brianrho/Rho85/README.md

# Rho85
An Intel 8085 microprocessor trainer
