brianrho/Rho85/CAD/readme.txt

This contains the Eagle .brd and .sch files, as well as PNG images of the schematic and PCB design. 
The schematic has been modified to correct the issues discovered during testing but the PCB design 
is still flawed; yet to be re-routed.
