brianrho/Rho85/CAD/pcb.png

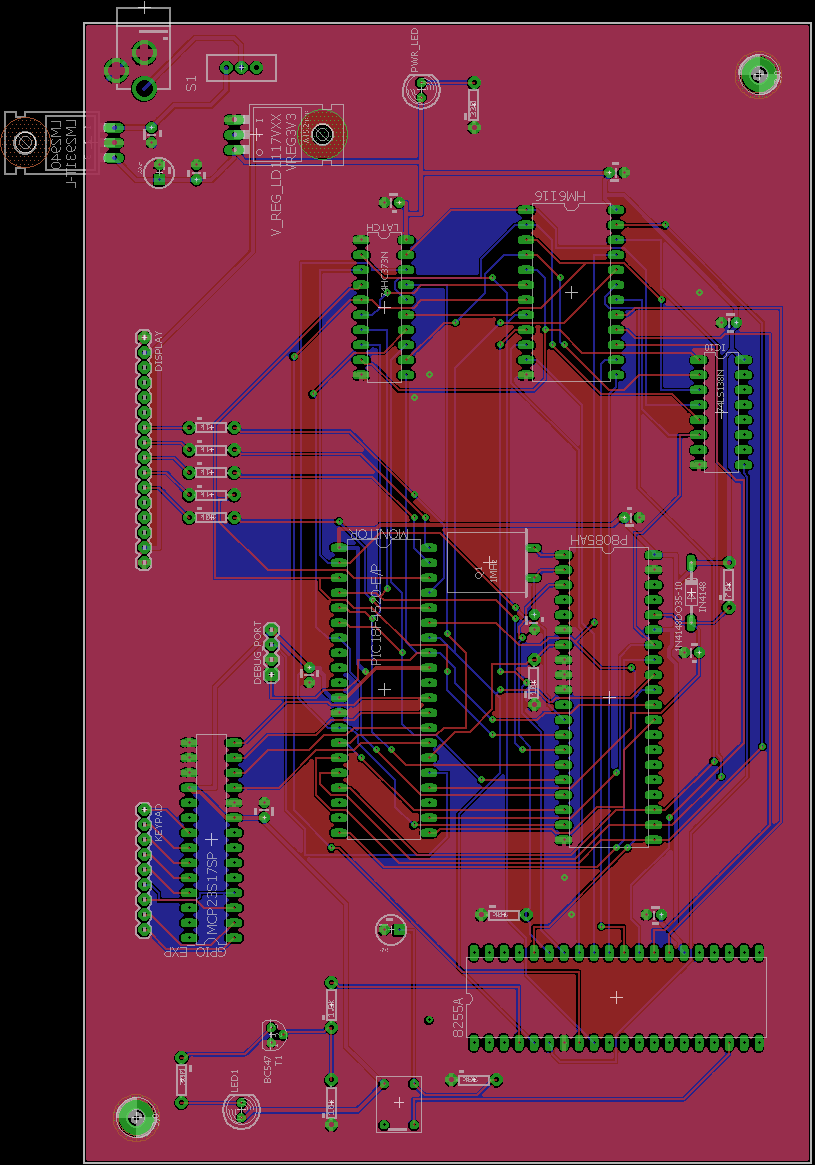
CAD/pcb.png
