brianrho/Rho85/CAD/schem.png

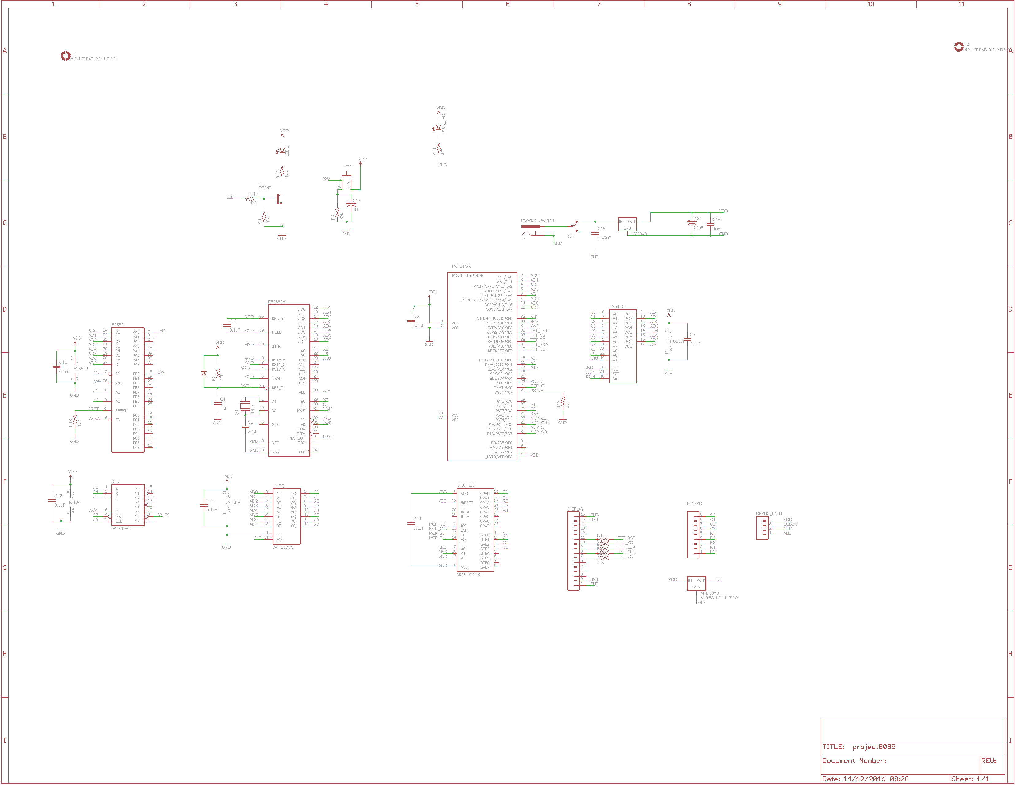
CAD/schem.png
