brianrho/Rho85/CAD/project8085.brd

## EAGLE design CAD/project8085.brd (2016-12-26)

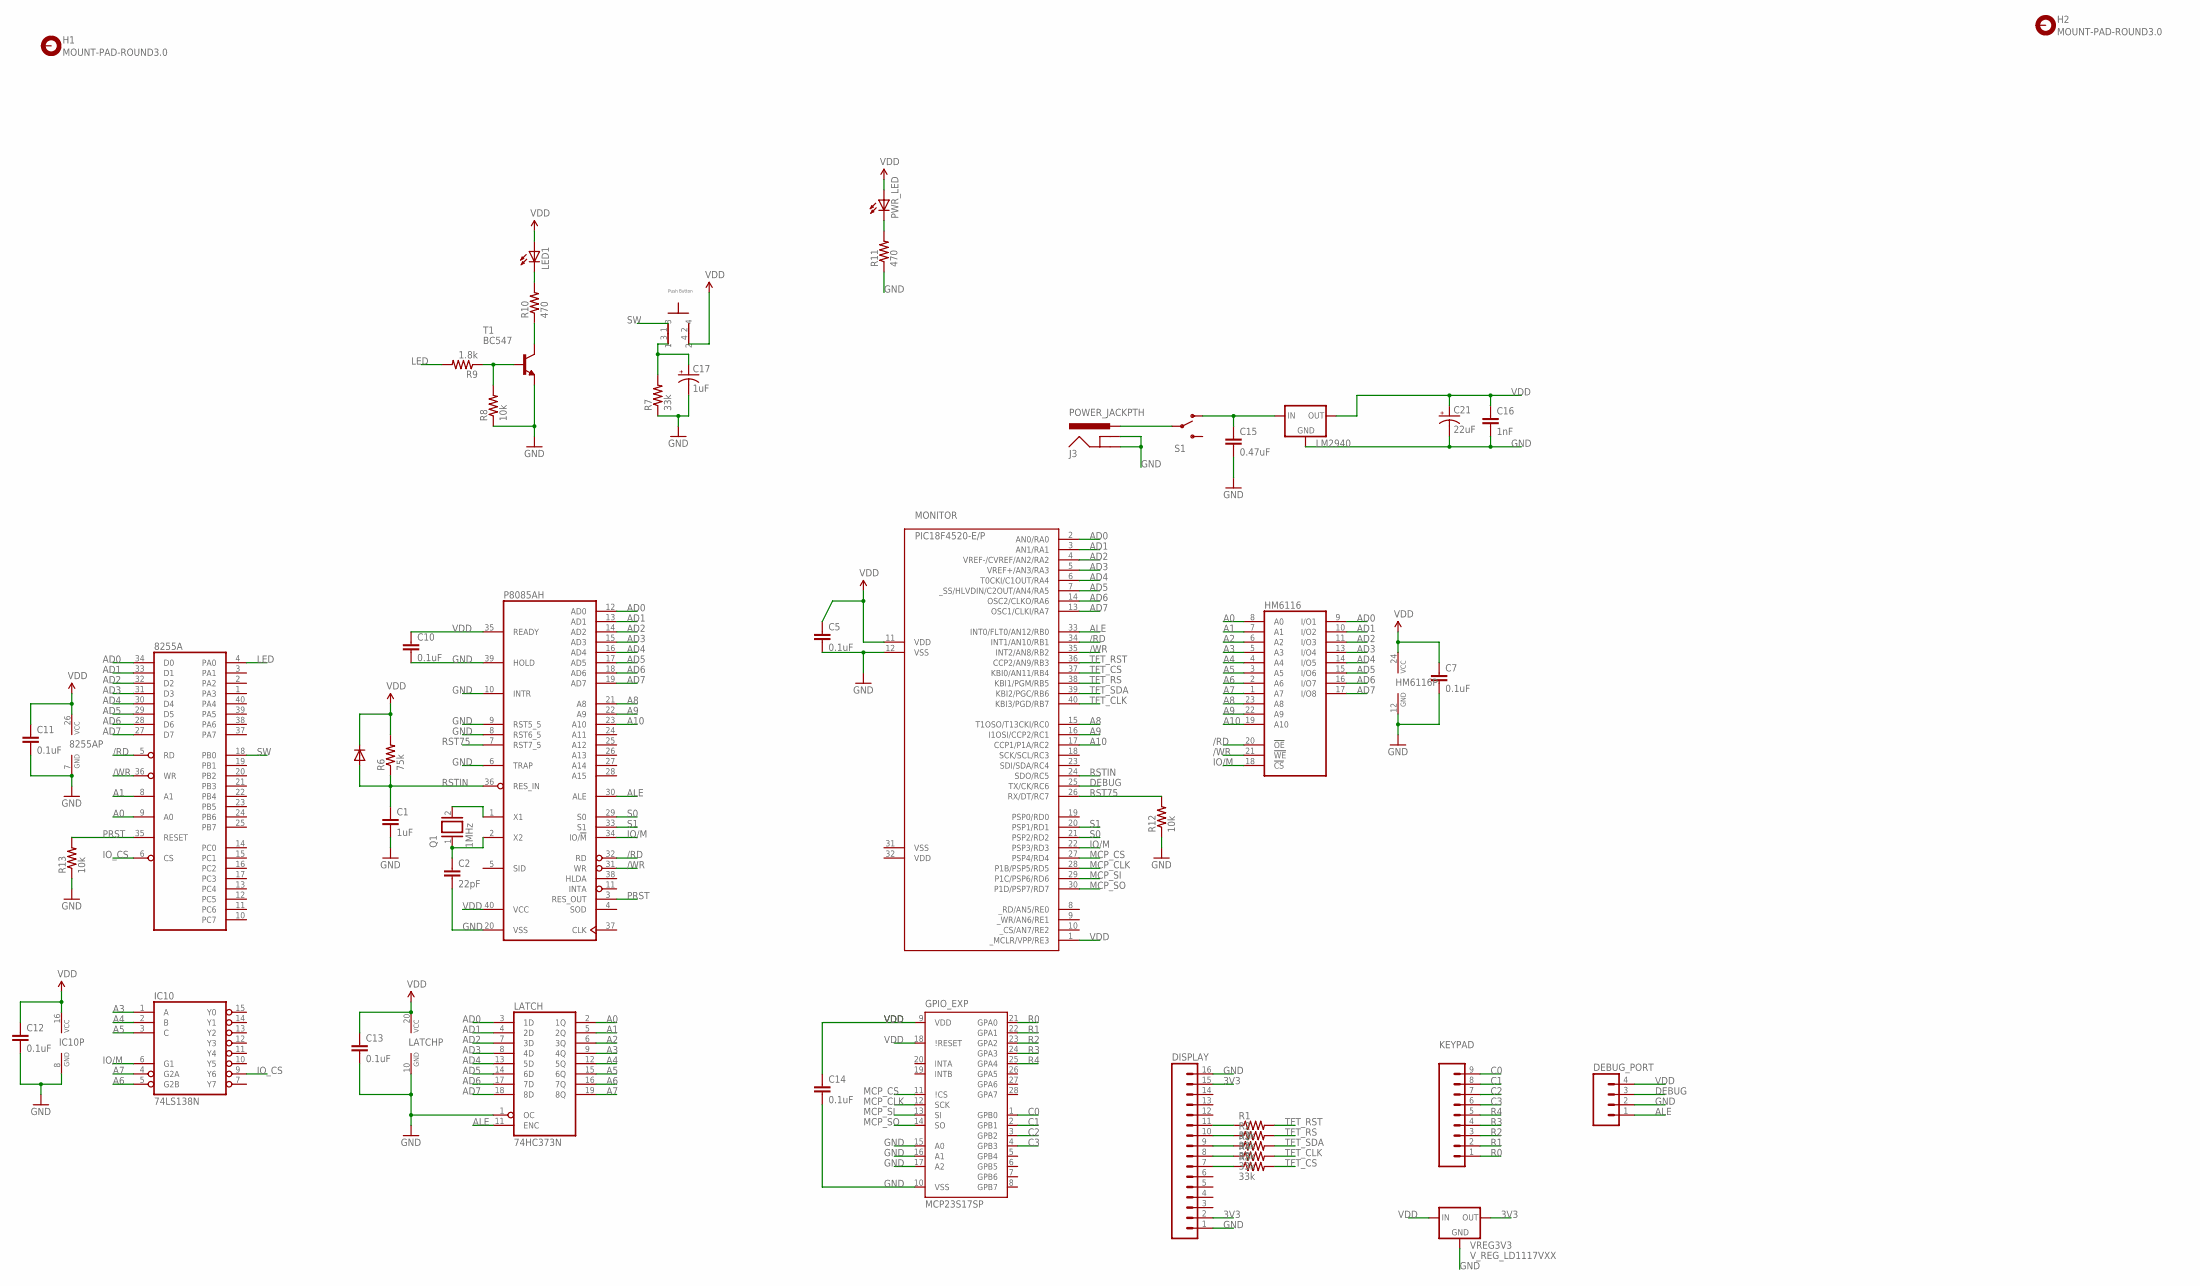
[picture p38: schematic project8085.sch]

Parts:
8255A: 8255A; DIL40
C1: 1uF; CAP-PTH-SMALL
C2: 22pF; CAP-PTH-SMALL
C5, C7, C10, C11, C12, C13, C14: 0.1uF; CAP-PTH-SMALL
C15: 0.47uF; CAP-PTH-SMALL
C16: 1nF; CAP-PTH-SMALL
C17: 1uF; CPOL-RADIAL-10UF-25V
C21: 22uF; CPOL-RADIAL-10UF-25V
DEBUG_PORT: M04PTH; 1X04
DISPLAY: M16PTH; 1X16
GPIO_EXP: MCP23S17SP; DIL28-3
H1, H2: MOUNT-PAD-ROUND3.0; 3,0-PAD
HM6116: 6116P; DIL24-6
IC10: 74LS138N; DIL16
IN4148: 1N4148DO35-10; DO35-10
J3: POWER_JACKPTH; POWER_JACK_PTH
KEYPAD: M09; 1X09
LATCH: 74HC373N; DIL20
LED1: LED5MM
LM2940: LM2931T-L; TO220L1
MONITOR: PIC18F4520-E/P; DIL40
P8085AH: 8085; DIL40
PWR_LED: LED5MM
Q1: 1MHz; Q
R1, R2, R3, R4, R5, R7: 33k; AXIAL-0.3
R6: 75k; AXIAL-0.3
R8, R12, R13: 10k; AXIAL-0.3
R9: 1.8k; AXIAL-0.3
R10, R11: 470; AXIAL-0.3
S1: SWITCH-SPDTPTH; SWITCH-SPDT
T1: BC547; TO92
U$3: PUSHBTN
VREG3V3: V_REG_LD1117VXX; 78XXL

Connections:
3V3: DISPLAY.2, DISPLAY.15, VREG3V3.GND (OUT)
/RD: 8255A.5 (RD), HM6116.20 (!OE), MONITOR.34 (INT1/AN10/RB1), P8085AH.32 (RD)
/WR: 8255A.36 (WR), HM6116.21 (!WE), MONITOR.35 (INT2/AN8/RB2), P8085AH.31 (WR)
A0: 8255A.9 (A0), HM6116.8 (A0), LATCH.2 (1Q)
A1: 8255A.8 (A1), HM6116.7 (A1), LATCH.5 (2Q)
A2: HM6116.6 (A2), LATCH.6 (3Q)
A3: HM6116.5 (A3), IC10.1 (A), LATCH.9 (4Q)
A4: HM6116.4 (A4), IC10.2 (B), LATCH.12 (5Q)
A5: HM6116.3 (A5), IC10.3 (C), LATCH.15 (6Q)
A6: HM6116.2 (A6), IC10.5 (G2B), LATCH.16 (7Q)
A7: HM6116.1 (A7), IC10.4 (G2A), LATCH.19 (8Q)
A8: HM6116.23 (A8), MONITOR.15 (T1OSO/T13CKI/RC0), P8085AH.21 (A8)
A9: HM6116.22 (A9), MONITOR.16 (I1OSI/CCP2/RC1), P8085AH.22 (A9)
A10: HM6116.19 (A10), MONITOR.17 (CCP1/P1A/RC2), P8085AH.23 (A10)
AD0: 8255A.34 (D0), HM6116.9 (I/O1), LATCH.3 (1D), MONITOR.2 (AN0/RA0), P8085AH.12 (AD0)
AD1: 8255A.33 (D1), HM6116.10 (I/O2), LATCH.4 (2D), MONITOR.3 (AN1/RA1), P8085AH.13 (AD1)
AD2: 8255A.32 (D2), HM6116.11 (I/O3), LATCH.7 (3D), MONITOR.4 (VREF-/CVREF/AN2/RA2), P8085AH.14 (AD2)
AD3: 8255A.31 (D3), HM6116.13 (I/O4), LATCH.8 (4D), MONITOR.5 (VREF+/AN3/RA3), P8085AH.15 (AD3)
AD4: 8255A.30 (D4), HM6116.14 (I/O5), LATCH.13 (5D), MONITOR.6 (T0CKI/C1OUT/RA4), P8085AH.16 (AD4)
AD5: 8255A.29 (D5), HM6116.15 (I/O6), LATCH.14 (6D), MONITOR.7 (_SS/HLVDIN/C2OUT/AN4/RA5), P8085AH.17 (AD5)
AD6: 8255A.28 (D6), HM6116.16 (I/O7), LATCH.17 (7D), MONITOR.14 (OSC2/CLKO/RA6), P8085AH.18 (AD6)
AD7: 8255A.27 (D7), HM6116.17 (I/O8), LATCH.18 (8D), MONITOR.13 (OSC1/CLKI/RA7), P8085AH.19 (AD7)
ALE: DEBUG_PORT.1, LATCH.11 (ENC), MONITOR.33 (INT0/FLT0/AN12/RB0), P8085AH.30 (ALE)
C0: GPIO_EXP.1 (GPB0), KEYPAD.9
C1: GPIO_EXP.2 (GPB1), KEYPAD.8
C2: GPIO_EXP.3 (GPB2), KEYPAD.7
C3: GPIO_EXP.4 (GPB3), KEYPAD.6
DEBUG: DEBUG_PORT.3, MONITOR.25 (TX/CK/RC6)
GND: 8255A.7 (GND), C1.2, C2.2, C5.2, C7.2, C10.2, C11.2, C12.2, C13.2, C14.2, C15.2, C16.2, C17.2 (-), C21.2 (-), DEBUG_PORT.2, DISPLAY.1, DISPLAY.16, GPIO_EXP.10 (VSS), GPIO_EXP.15 (A0), GPIO_EXP.16 (A1), GPIO_EXP.17 (A2), HM6116.12 (GND), IC10.8 (GND), J3.GND, J3.GNDBREAK, LATCH.1 (OC), LATCH.10 (GND), LM2940.2 (GND), MONITOR.12 (VSS), P8085AH.6 (TRAP), P8085AH.8 (RST6_5), P8085AH.9 (RST5_5), P8085AH.10 (INTR), P8085AH.20 (VSS), P8085AH.39 (HOLD), R7.P$1 (1), R8.P$1 (1), R11.P$1 (1), R12.P$1 (1), R13.P$1 (1), T1.1 (E), VREG3V3.IN (GND)
IO/M: HM6116.18 (!CS), IC10.6 (G1), MONITOR.22 (PSP3/RD3), P8085AH.34 (IO/!M)
IO_CS: 8255A.6 (CS), IC10.9 (Y6)
LED: 8255A.4 (PA0), R9.P$2 (2)
MCP_CLK: GPIO_EXP.12 (SCK), MONITOR.28 (P1B/PSP5/RD5)
MCP_CS: GPIO_EXP.11 (\!CS), MONITOR.27 (PSP4/RD4)
MCP_SI: GPIO_EXP.13 (SI), MONITOR.29 (P1C/PSP6/RD6)
MCP_SO: GPIO_EXP.14 (SO), MONITOR.30 (P1D/PSP7/RD7)
unnamed: R8.P$2 (2), R9.P$1 (1), T1.2 (B)
unnamed: C15.1, LM2940.1 (IN), S1.1 (O)
unnamed: C2.1, P8085AH.2 (X2), Q1.1
unnamed: P8085AH.1 (X1), Q1.2
unnamed: J3.PWR, S1.2
unnamed: DISPLAY.11, R1.P$1 (1)
unnamed: DISPLAY.10, R2.P$1 (1)
unnamed: DISPLAY.9, R3.P$1 (1)
unnamed: DISPLAY.8, R4.P$1 (1)
unnamed: DISPLAY.7, R5.P$1 (1)
unnamed: PWR_LED.K (C), R11.P$2 (2)
unnamed: R10.P$1 (1), T1.3 (C)
unnamed: LED1.K (C), R10.P$2 (2)
PRST: 8255A.35 (RESET), P8085AH.3 (RES_OUT), R13.P$2 (2)
R0: GPIO_EXP.21 (GPA0), KEYPAD.1
R1: GPIO_EXP.22 (GPA1), KEYPAD.2
R2: GPIO_EXP.23 (GPA2), KEYPAD.3
R3: GPIO_EXP.24 (GPA3), KEYPAD.4
R4: GPIO_EXP.25 (GPA4), KEYPAD.5
RST75: MONITOR.26 (RX/DT/RC7), P8085AH.7 (RST7_5), R12.P$2 (2)
RSTIN: C1.1, IN4148.A, MONITOR.24 (SDO/RC5), P8085AH.36 (RES_IN), R6.P$1 (1)
S0: MONITOR.21 (PSP2/RD2), P8085AH.29 (S0)
S1: MONITOR.20 (PSP1/RD1), P8085AH.33 (S1)
SW: 8255A.18 (PB0), U$3.1
SW0: C17.1 (+), R7.P$2 (2), U$3.3
TFT_CLK: MONITOR.40 (KBI3/PGD/RB7), R4.P$2 (2)
TFT_CS: MONITOR.37 (KBI0/AN11/RB4), R5.P$2 (2)
TFT_RS: MONITOR.38 (KBI1/PGM/RB5), R2.P$2 (2)
TFT_RST: MONITOR.36 (CCP2/AN9/RB3), R1.P$2 (2)
TFT_SDA: MONITOR.39 (KBI2/PGC/RB6), R3.P$2 (2)
VDD: 8255A.26 (VCC), C5.1, C7.1, C10.1, C11.1, C12.1, C13.1, C14.1, C16.1, C21.1 (+), DEBUG_PORT.4, GPIO_EXP.9 (VDD), GPIO_EXP.18 (\!RESET), HM6116.24 (VCC), IC10.16 (VCC), IN4148.C, LATCH.20 (VCC), LED1.A, LM2940.3 (OUT), MONITOR.1 (_MCLR/VPP/RE3), MONITOR.11 (VDD), MONITOR.32 (VDD), P8085AH.35 (READY), P8085AH.40 (VCC), PWR_LED.A, R6.P$2 (2), U$3.4, VREG3V3.OUT (IN)
VSS: MONITOR.31 (VSS)

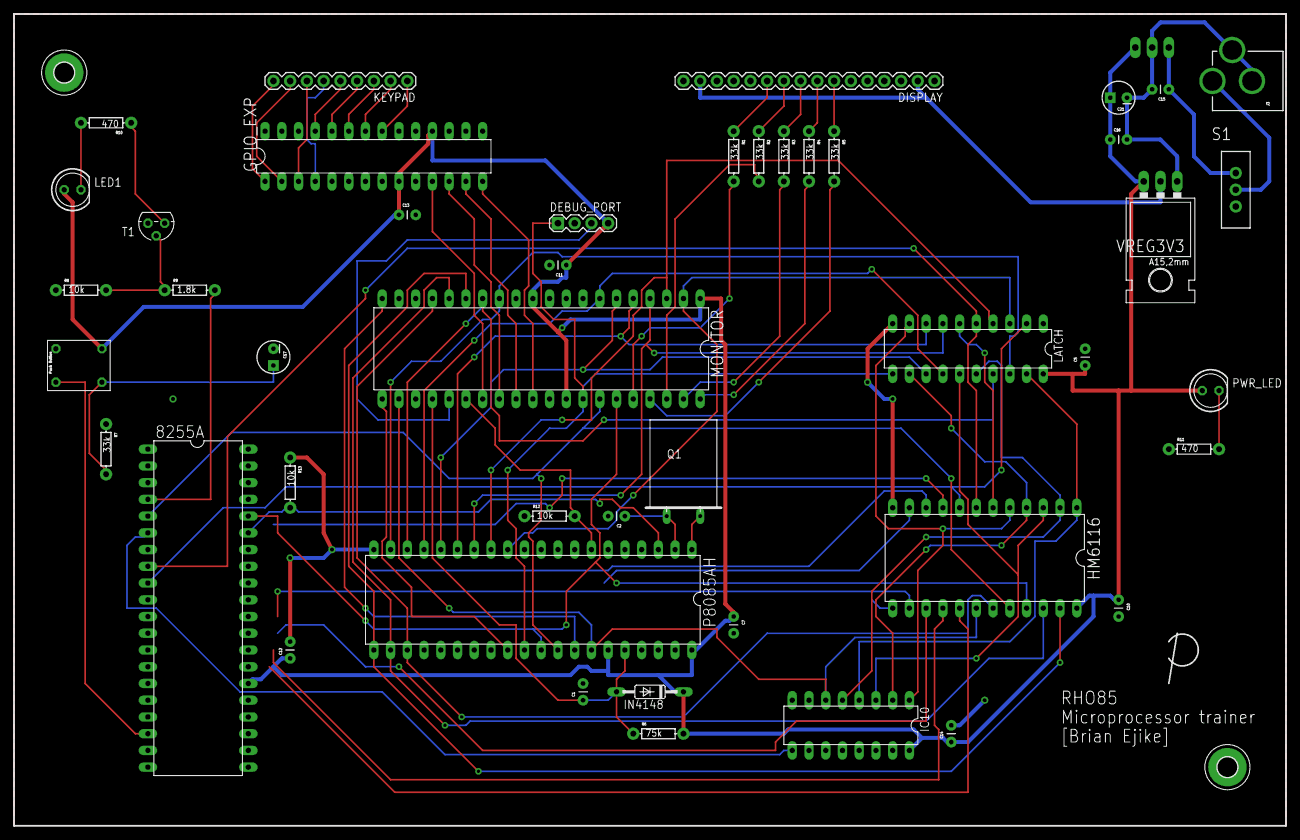
[picture p39: board project8085.brd from above]

Board: 2 copper layers, 193.0 x 123.2 mm, 48 parts (1 on the bottom side), 67 nets.
