brianrho/Rho85/gfxfont.h

// Font structures for newer Adafruit_GFX (1.1 and later).
// Example fonts are included in 'Fonts' directory.
// To use a font in your Arduino sketch, #include the corresponding .h
// file and pass address of GFXfont struct to setFont().  Pass NULL to
// revert to 'classic' fixed-space bitmap font.

#ifndef _GFXFONT_H_
#define _GFXFONT_H_

typedef struct { // Data stored PER GLYPH
	uint16_t bitmapOffset;     // Pointer into GFXfont->bitmap
	uint8_t  width, height;    // Bitmap dimensions in pixels
	uint8_t  xAdvance;         // Distance to advance cursor (x axis)
	int8_t   xOffset, yOffset; // Dist from cursor pos to UL corner
} GFXglyph;

typedef struct { // Data stored for FONT AS A WHOLE:
	uint8_t  *bitmap;      // Glyph bitmaps, concatenated
	GFXglyph *glyph;       // Glyph array
	uint8_t   first, last; // ASCII extents
	uint8_t   yAdvance;    // Newline distance (y axis)
} GFXfont;

const uint8_t mono_bold_bitmaps[] = {
  0xFF, 0xFF, 0xFF, 0xF6, 0x66, 0x60, 0x6F, 0x60, 0xE7, 0xE7, 0x62, 0x42,
  0x42, 0x42, 0x42, 0x11, 0x87, 0x30, 0xC6, 0x18, 0xC3, 0x31, 0xFF, 0xFF,
  0xF9, 0x98, 0x33, 0x06, 0x60, 0xCC, 0x7F, 0xEF, 0xFC, 0x66, 0x0C, 0xC3,
  0x98, 0x63, 0x04, 0x40, 0x0C, 0x03, 0x00, 0xC0, 0xFE, 0x7F, 0x9C, 0x66,
  0x09, 0x80, 0x78, 0x0F, 0xE0, 0x7F, 0x03, 0xE0, 0xF8, 0x7F, 0xFB, 0xFC,
  0x0C, 0x03, 0x00, 0xC0, 0x30, 0x38, 0x1F, 0x0C, 0x42, 0x10, 0xC4, 0x1F,
  0x03, 0x9C, 0x3C, 0x7F, 0x33, 0xE0, 0x8C, 0x21, 0x08, 0xC3, 0xE0, 0x70,
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
  {   443,   9,  14,  14,    3,  -13 },   // 0x3F '?'
  {   459,  11,  19,  14,    2,  -14 },   // 0x40 '@'
  {   486,  15,  14,  14,   -1,  -13 },   // 0x41 'A'
  {   513,  13,  14,  14,    0,  -13 },   // 0x42 'B'
  {   536,  12,  14,  14,    1,  -13 },   // 0x43 'C'
  {   557,  12,  14,  14,    1,  -13 },   // 0x44 'D'
  {   578,  13,  14,  14,    0,  -13 },   // 0x45 'E'
  {   601,  13,  14,  14,    0,  -13 },   // 0x46 'F'
  {   624,  13,  14,  14,    1,  -13 },   // 0x47 'G'
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

const GFXfont gfxFont = {
  (uint8_t  *)mono_bold_bitmaps,
  (GFXglyph *)mono_bold_glyphs,
  0x20, 0x7E, 24 };

// Approx. 2402 bytes

#endif // _GFXFONT_H_
