brianrho/Rho85/(commit log)

2016-12-26 Uploaded CAD files
    [project8085.brd, project8085.sch]
2024-01-12 Add missing mpu files
    [mpu.c, mpu.h]
